bianca10naftanaila/Earthquake-detector/Project-pdf.pdf

UNIVERSITATEA POLITEHNICA BUCUREȘTI Facultatea de Electronică, Telecomunicații și Tehnologia Informației

Centrul de Electronică Tehnologică și Tehnici de Interconectare

## PROIECT TEHNOLOGII DE INTERCONECTARE ÎN ELECTRONICĂ

2022-2023

## „DETECTOR DE CUTREMUR”

STUDENȚI : | DATA DE PREDARE :
- Năftănăilă Bianca-Elena-422C | Iunie 2023
- Năftănăilă Luiza-Georgiana-422C
- Stroe Florin-Daniel-423D

COORDONATOR : Prof. Dr. Ing. Norocel-Dragoș Codreanu

## Cuprins

19. ANEXE

## Date inițiale de proiectare

Scopul acestui proiect este de a realiza design-ul PCB al unui detector de cutremur, conform unei scheme electrice și a unor parametrii dați. Detectorul de cutremur este realizat dintr-un piezoelement, care prin intermediul cristalelor de zirconat de plumb prezente în strucura sa, poate stoca cu ușurință curentul și îl poate elibera atunci când orientările cristalelor sunt perturbate prin vibrații mecanice, dintr-un amplificator operațional ce amplifică semnalele de la elementul piezoelectric și dintr-un dispozitiv stabil (timer) care generează întârzieri precise sau oscilații. Schema electrică a circuitului este reprezentată în figura Fig.1, iar detaliile despre aceasta se regăsesc în ANEXA 1.

Proiectul PCB va fi realizat utilizând două straturi electrice, TOP și BOTTOM. Componentele vor fi plasate pe stratul TOP, traseele de semnal vor avea lățimea de 0,4mm, traseele de alimentare vor avea lățimea de 1,0mm, conexiunea cu masa va fi realizată printr-un plan de masă pe stratul BOTTOM, iar spațierea în toate cazurile va fi de 0,4mm. Placa va fi dreptunghiulară, cu dimensiunea lungimii de 65mm și a lățimii de 55mm. Se vor plasa patru găuri nemetalizate de prindere în toate cele patru colțuri ale plăcii cu diametrul de 3,2mm. Fiecare gaură se va afla la 1,5 M (3,81mm) față de colțul în dreptul căruia a fost plasată. Aceste constrângeri de proiectare sunt specificate in ANEXA 2, linia 7.

Mai departe vor fi puse în evidență schema electrică a circuitului în programul „OrCAD Capture CIS”, o descriere a circuitului, cât și layer-ele proiectului PCB. Foile de catalog pentru componentele utilizate și link-urile propuse pentru achiziționarea acestora se găsesc în directorul „Foi de catalog”, fișierele pentru realizarea proiectului PCB se află în directorul „Fișiere pentru fabricație”, iar proiectul realizat în programul OrCAD se regăsește în directorul „Proiect PCB”. Toate aceste directoare se găsesc pe discul anexat. De asemenea, o propunere de proiectare mecanică a proiectului se află în ANEXA 5.

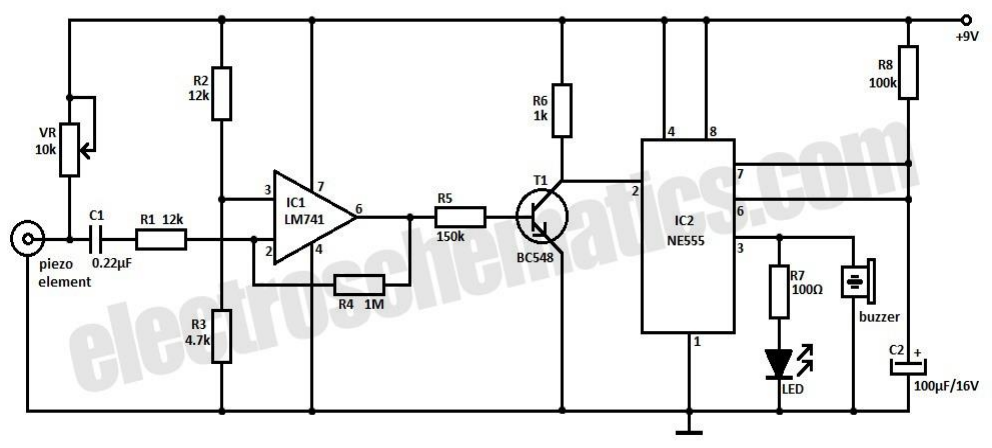
[picture p1: figure]

## Descriere a funcționării schemei proiectate

Componentele necesare schemei electrice sunt: circuit integrat NE555, buzzer, amplificator operațional LM741, potențiometru, piezoelement, condensator, rezistor, LED, tranzistor NPN.

Una dintre componentele principale ale schemei electrice este circuitul integrat NE555, un dispozitiv extrem de stabil pentru generarea unor întârzieri de timp precise sau oscilații. Acesta este alcătuit din 8 pini. Pinul 3 este conectat cu buzzer-ul și cu LED-ul pentru a sesiza vibrația. Terminalele suplimentare asigură declanșarea sau resetarea, dacă se dorește. În modul de funcționare a întârzierii, timpul este controlat cu precizie de un rezistor și de un condensator extern. Pentru o funcționare stabilă ca oscilator, frecvența de funcționare liberă și ciclul de funcționare sunt controlate cu precizie prin doi rezistori externi și un condensator.

Dispozitivul LM741 este un amplificator operațional ce prezintă performanțe îmbunătățite, destinat unei game largi de aplicații analogice. Câștigul mare și gama largă de tensiuni de operare oferă performanțe superioare în integrator. Așadar, IC1 LM741 este conectat în circuit ca un amplificator diferențial ale cărui intrări, atât cea inversoare, cât și cea neinversoare , sunt legate de borna negativă printr-o rețea rezistivă care cuprinde R1 și R4. În condiții de inactivitate (ajustată de VR1), ambele intrări primesc tensiuni aproape egale.

De asemenea, este utilizat un senzor piezo standard ce detectează vibrațiile/sunetele cauzate de schimbările de presiune. Prin intermediul cristalelor de zirconat de plumb prezente în strucura sa, poate stoca cu ușurință curentul și îl poate elibera atunci când orientările cristalelor sunt perturbate de vibrațiile mecanice Astfel, elementul piezo acționează ca un mic condensator ce are o capacitate de câțiva nanofarazi. De aceea, la fel ca un condensator, acesta stochează sarcina atunci când un potențial este aplicat la bornele sale.

Când elementul piezo este perturbat (chiar și de o mișcare ușoară), acesta descarcă încărcătura stocată. Acest lucru modifică nivelul de tensiune la intrările lui IC1 și ieșirea oscilează momentan în sus. Această ieșire ridicată este utilizată pentru a declanșa tranzistorul de comutare T1, care la rândul său declanșează monostabilul IC2. Ieșirea ridicată a acestuia activează soneria buzzer-ului și determină aprinderea LED-ului.

## Schema electrică

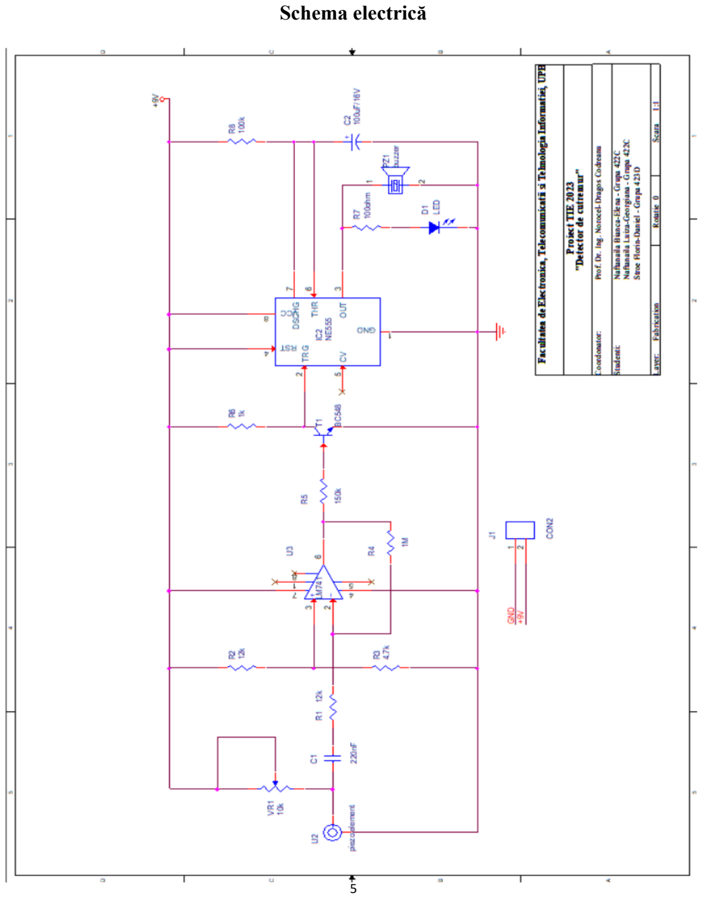
[picture p2: page 5]

## Raport de postprocesare „Design Rules Check”(DRC)

Design Rules Check

Checking Schematic: SCHEMATIC1

Checking Electrical Rules

Checking For Single Node Nets

Checking For Unconnected Bus Nets

## Raport de postprocesare „Cross Reference”(CR)

Cross Reference | Page1
Item | Part | Reference | SchematicName | Sheet | Library

____________________________________________________________________________

1 | 1M | R4 | SCHEMATIC1/PAGE1 | 1
C:\CADENCE\SPB_17.2\TOOLS\CAPTURE\LIBRARY\DISCRETE.OLB
2 | 1k | R6 | SCHEMATIC1/PAGE1 | 1
C:\CADENCE\SPB_17.2\TOOLS\CAPTURE\LIBRARY\DISCRETE.OLB
3 | 4.7k | R3 | SCHEMATIC1/PAGE1 | 1
C:\CADENCE\SPB_17.2\TOOLS\CAPTURE\LIBRARY\DISCRETE.OLB
4 | 10k | VR1 | SCHEMATIC1/PAGE1 | 1
C:\CADENCE\SPB_17.2\TOOLS\CAPTURE\LIBRARY\DISCRETE.OLB
5 | 12K | R1 | SCHEMATIC1/PAGE1 | 1
C:\CADENCE\SPB_17.2\TOOLS\CAPTURE\LIBRARY\DISCRETE.OLB
6 | 12K | R2 | SCHEMATIC1/PAGE1 | 1
C:\CADENCE\SPB_17.2\TOOLS\CAPTURE\LIBRARY\DISCRETE.OLB
7 | 100k | R8 | SCHEMATIC1/PAGE1 | 1
C:\CADENCE\SPB_17.2\TOOLS\CAPTURE\LIBRARY\DISCRETE.OLB
8 | 100ohm | R7 | SCHEMATIC1/PAGE1 | 1
C:\CADENCE\SPB_17.2\TOOLS\CAPTURE\LIBRARY\DISCRETE.OLB
9 | 100uF/16V C2 | SCHEMATIC1/PAGE1 | 1
C:\CADENCE\SPB_17.2\TOOLS\CAPTURE\LIBRARY\DISCRETE.OLB
10 | 150k | R5 | SCHEMATIC1/PAGE1 | 1
C:\CADENCE\SPB_17.2\TOOLS\CAPTURE\LIBRARY\DISCRETE.OLB
11 | 220nF | C1 | SCHEMATIC1/PAGE1 | 1
C:\CADENCE\SPB_17.2\TOOLS\CAPTURE\LIBRARY\DISCRETE.OLB
12 | BC548 | T1 | SCHEMATIC1/PAGE1 | 1
C:\CADENCE\SPB_17.2\TOOLS\CAPTURE\LIBRARY\TRANSISTOR.OLB
13 | CON2 | J1 | SCHEMATIC1/PAGE1 | 1
C:\CADENCE\SPB_17.2\TOOLS\CAPTURE\LIBRARY\CONNECTOR.OLB
14 | LED | D1 | SCHEMATIC1/PAGE1 | 1
C:\CADENCE\SPB_17.2\TOOLS\CAPTURE\LIBRARY\DISCRETE.OLB
15 | LM741 | IC1 | SCHEMATIC1/PAGE1 | 1
C:\CADENCE\SPB_17.2\TOOLS\CAPTURE\LIBRARY\OPAMP.OLB
16 | NE555 | IC2 | SCHEMATIC1/PAGE1 | 1 | C:\USERS\USER\DESKTOP\TIE
LABORATOR\PROIECT_TIE_DETECTOR_DE_CUTREMUR.DSN
17 | buzzer | PZ1 | SCHEMATIC1/PAGE1 | 1
C:\CADENCE\SPB_17.2\TOOLS\CAPTURE\LIBRARY\DISCRETE.OLB
18 | piezo element U2 | SCHEMATIC1/PAGE1 | 1
C:\CADENCE\SPB_17.2\TOOLS\CAPTURE\LIBRARY\PIEZOELEMENT.OLB

## Raport de postprocesare „Bill of Materials”(BOM)

Bill Of Materials | Page1
Item | Quantity | Reference | Part

______________________________________________

1 | 1 | C1 | 220nF
2 | 1 | C2 | 100uF/16V
3 | 1 | D1 | LED
4 | 1 | IC1 | LM741
5 | 1 | IC2 | NE555
6 | 1 | J1 | CON2
7 | 1 | PZ1 | buzzer
8 | 2 | R1,R2 | 12k
9 | 1 | R3 | 4.7k
10 | 1 | R4 | 1M
11 | 1 | R5 | 150k
12 | 1 | R6 | 1k
13 | 1 | R7 | 100ohm
14 | 1 | R8 | 100k
15 | 1 | T1 | BC548
16 | 1 | U2 | piezo element
17 | 1 | VR1 | 10k

Nr. Curent | Cantitate | Referință | Componentă | Descrierere | Montare | Capsulă | Producător | Distribuitor | Cod Produs | Preț / buc. (RON) | Cantitate minimă | Preț total
1 | 1 | U2 | piezo element | Piezo Element, Sounder, 9.5 kHz, 8000 pF, 12 mm, 0.22 mm | THT | JUMPER2 | MULTICOMP PRO | ro.farnell.com | MCABT-456-RC | 2,07 | 1 | 2,07
2 | 1 | VR1 | 10k | Trimpot, Single Turn, Cermet, Top Adjust, 10 kohm, Surface Mount, 1 Turns | SMD | POT | BOURNS | ro.farnell.com | TC33X-2-103E | 1,18 | 5 | 5,9
3 | 1 | C1 | 220 nF | SMD Multilayer Ceramic Capacitor, 0.22 µF, 50 V, 1206 [3216 Metric], ± 10%, X7R, CC Series | SMD | CAPCK06 | YAGEO | ro.farnell.com | CC1206KKX7R9BB224 | 0,5831 | 5 | 2,9
4 | 2 | R1, R2 | 12k | METAL FILM RESISTOR, 12KOHM, 125mW, 1% | THT | RES400 | MULTICOMP PRO | ro.farnell.com | MCMF0W8FF1202A20 | 0,357 | 1 | 0,357
5 | 1 | R3 | 4,7k | CARBON FILM RESISTOR, 4.7KOHM, 500mW 5% | THT | RES400 | MULTICOMP PRO | ro.farnell.com | MCCFR0S2J0472A20 | 0,42 | 1 | 0,42
6 | 1 | R4 | 1M | SMD Chip Resistor, Ceramic, 1 Mohm, ± 1%, 62.5 mW, 0402 [1005 Metric], Thick Film, Sulfur Resistant | SMD | SMR1206 | MULTICOMP PRO | ro.farnell.com | MCMR04X1004FTL | 0,0476 | 10 | 0,476
7 | 1 | R5 | 150k | SMD Chip Resistor, 150 kohm, ± 1%, 62.5 mW, 0402 [1005 Metric], Thick Film, General Purpose | SMD | SMR1206 | TE CONNECTIVITY | ro.farnell.com | CRG0402F150K | 0,0238 | 10 | 0,238
8 | 1 | R6 | 1k | METAL FILM RESISTOR, 1KOHM, 250mW, 1% | THT | RES400 | MULTICOMP PRO | ro.farnell.com | MCMF0W4FF1001A50 | 0,4522 | 1 | 0,4522
9 | 1 | R7 | 100ohm | SMD Chip Resistor, Ceramic, 100 ohm, ± 1%, 100 mW, 0603 [1608 Metric], Thick Film, Sulfur Resistant | SMD | 0603 (1608 Metric) | MULTICOMP PRO | ro.farnell.com | MCMR06X1000FTL | 0,0595 | 10 | 0,595
10 | 1 | R8 | 100k | SMD Chip Resistor, 100 kohm, ± 1%, 100 mW, 0603 [1608 Metric], Thick Film, General Purpose | SMD | 0603 (1608 Metric) | YAGEO | ro.farnell.com | RC0603FR-13100KL | 0,0476 | 10 | 0,476
11 | 1 | J1 | CON2 | Standard Terminal Block, CTB, 2 Contacts, 5 mm, Terminal Block, PCB Mount, 12 AWG | THT | JUMPER2 | CAMDENBOSS | ro.farnell.com | CTB55VG/2 | 2,2 | 1 | 2,2
12 | 1 | T1 | BC548 | Bipolar (BJT) Single Transistor, NPN, 65 V, 100 mA, 250 mW, SOT-23, Surface Mount | SMD | SOT-23 | MULTICOMP PRO | ro.farnell.com | BC846B | 0,6307 | 5 | 3,1535
13 | 1 | C2 | 100 uF/16V | Electrolytic Capacitor, 100 µF, 25 V, ± 20%, Radial Leaded, 2000 hours @ 85°C, Polar | THT | CAP196 | MULTICOMP PRO | ro.farnell.com | MCGPR25V107M6.3X11 | 0,7735 | 1 | 0,7735
14 | 1 | PZ1 | buzzer | Buzzer, Continuous, PS Series, 3V, 4 kHz, 75dBA, Through Hole | THT | JUMPER2 | TDK | ro.farnell.com | PS1440P02BT | 3,8437 | 1 | 3,8437
15 | 1 | D1 | LED | LED, Cool White, Through Hole, T-1 3/4 (5mm), 20 mA, 3.2 V, 4.18 cd | THT | CAP196 | CREE LED | ro.farnell.com | C535A-WJN-CU0W0231 | 1,2376 | 1 | 1,2376
16 | 1 | IC1 | LM741 | Operational Amplifier, 1 Amplifier, 1 MHz, 0.5 V/µs, 10V to 36V, DIP, 8 Pins | SMD | DIP8_3 | TEXAS INSTRUMENTS | ro.farnell.com | LM741CN/NOPB | 5,0337 | 1 | 5,0337
17 | 1 | IC2 | NE555 | Precision Timer IC, Timing Microseconds to Hours, TTL, Astable, Monostable, 4.5 V to 16 V, SOIC-8 | SMD | SOIC-8 | TEXAS INSTRUMENTS | ro.farnell.com | NE555D | 2,8917 | 1 | 2,8917

## Raport de postprocesare „Bill of Materials”(BOM-Avansat)

Preț total: 33,0179 lei

## Raport de postprocesare „Wirelist”(WR)

Wire List

<<< Component List >>>

220nF | C1 | CAPCK06
100uF/16V | C2 | CAP196
LED | D1 | CAP196
LM741 | IC1 | DIP8_3
NE555 | IC2 | SOIC8
CON2 | J1 | JUMPER2
buzzer | PZ1 | JUMPER2
12k | R1 | RES400
12k | R2 | RES400
4.7k | R3 | RES400
1M | R4 | SMR1206
150k | R5 | SMR1206
1k | R6 | RES400
100ohm | R7 | RES1608X50N_0603
100k | R8 | RES1608X50N_0603
BC548 | T1 | SOT23_3
piezo element | U2 | JUMPER2
10k | VR1 | POT

<<< Wire List >>>

NODE REFERENCE PIN # PIN NAME | PIN TYPE | PART VALUE
[00001] +9V
IC1 | 7 | V+ | Power | LM741
IC2 | 4 | RST | Input | NE555
IC2 | 8 | VCC | Power | NE555
R2 | 1 | 1 | Passive | 12k

R6 | 1 | 1 | Passive | 1k
R8 | 1 | 1 | Passive | 100k
J1 | 2 | 2 | Passive | CON2
VR1 | 1 | A | Passive | 10k
VR1 | 2 | WIPER | Passive | 10k
[00002] GND
IC1 | 4 | V- | Power | LM741
IC2 | 1 | GND | Power | NE555
T1 | 1 | EMITTER | Passive | BC548
R3 | 2 | 2 | Passive | 4.7k
C2 | 2 | 2 | Passive | 100uF/16V
J1 | 1 | 1 | Passive | CON2
PZ1 | 2 | - | Passive | buzzer
D1 | 2 | CATHODE | Passive | LED
U2 | 2 | pin2 | Passive | piezo element
[00003] N00855
R2 | 2 | 2 | Passive | 12k
R3 | 1 | 1 | Passive | 4.7k
[00004] N00880
C1 | 2 | 2 | Passive | 220nF
VR1 | 3 | B | Passive | 10k
U2 | 1 | pin1 | Passive | piezo element
[00005] N00920
IC2 | 6 | THR | Input | NE555
IC2 | 7 | DSCHG | Passive | NE555
R8 | 2 | 2 | Passive | 100k
C2 | 1 | 1 | Passive | 100uF/16V

[00006] N00981
IC2 | 2 | TRG | Input | NE555
T1 | 3 | COLLECTOR | Passive | BC548
R6 | 2 | 2 | Passive | 1k
[00007] N01004
T1 | 2 | BASE | Input | BC548
R5 | 2 | 2 | Passive | 150k
[00008] N01012
R4 | 2 | 2 | Passive | 1M
R5 | 1 | 1 | Passive | 150k
[00009] N01016
R1 | 2 | 2 | Passive | 12k
R4 | 1 | 1 | Passive | 1M
[00010] N01043
C1 | 1 | 1 | Passive | 220nF
R1 | 1 | 1 | Passive | 12k
[00011] N01268
IC2 | 3 | OUT | Output | NE555
R7 | 1 | 1 | Passive | 100ohm
PZ1 | 1 | + | Passive | buzzer
[00012] N01306
R7 | 2 | 2 | Passive | 100ohm
D1 | 1 | ANODE | Passive | LED

## Verificarea net-urilor

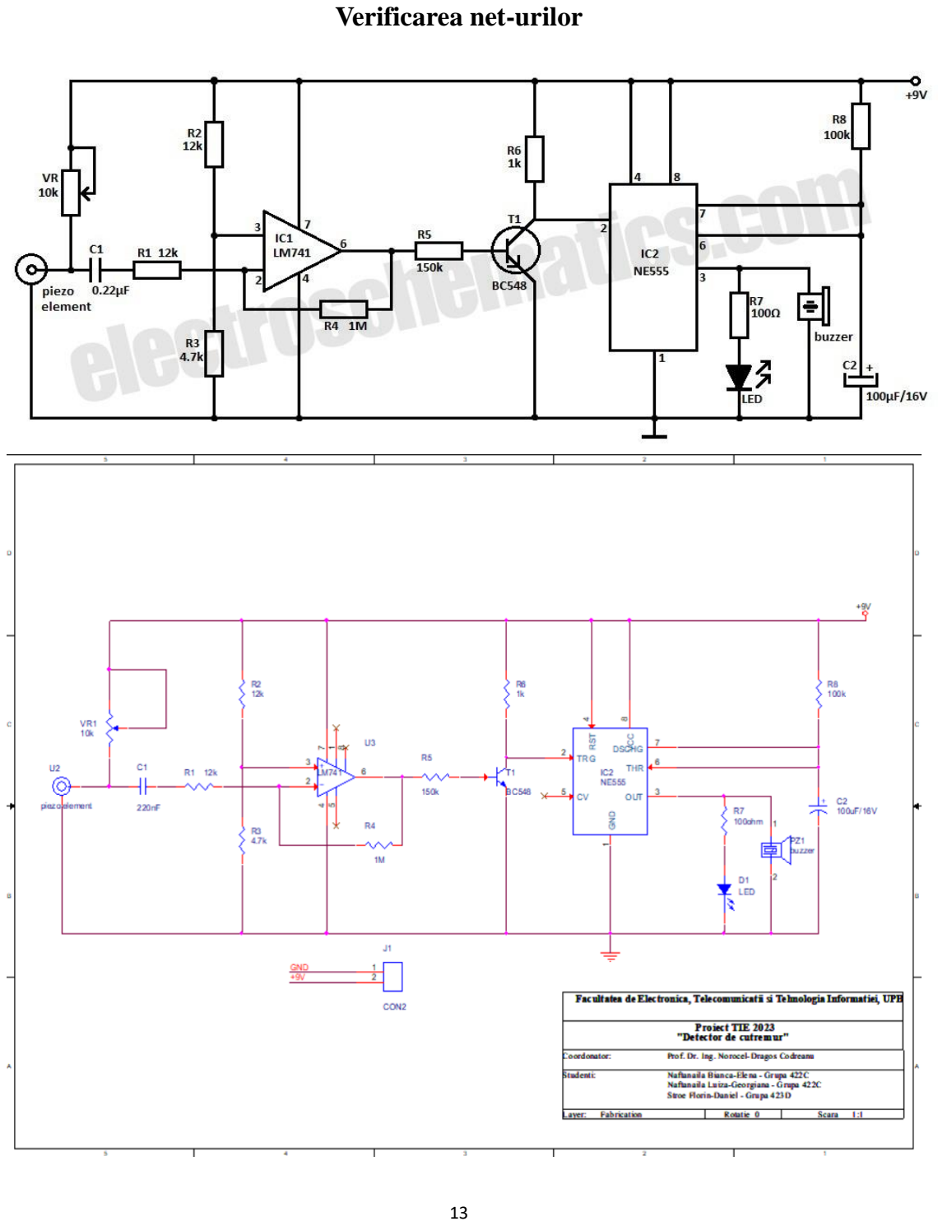
[picture p3: page 13]

## Layout-ul generat de straturile electrice „TOP” și „BOTTOM”

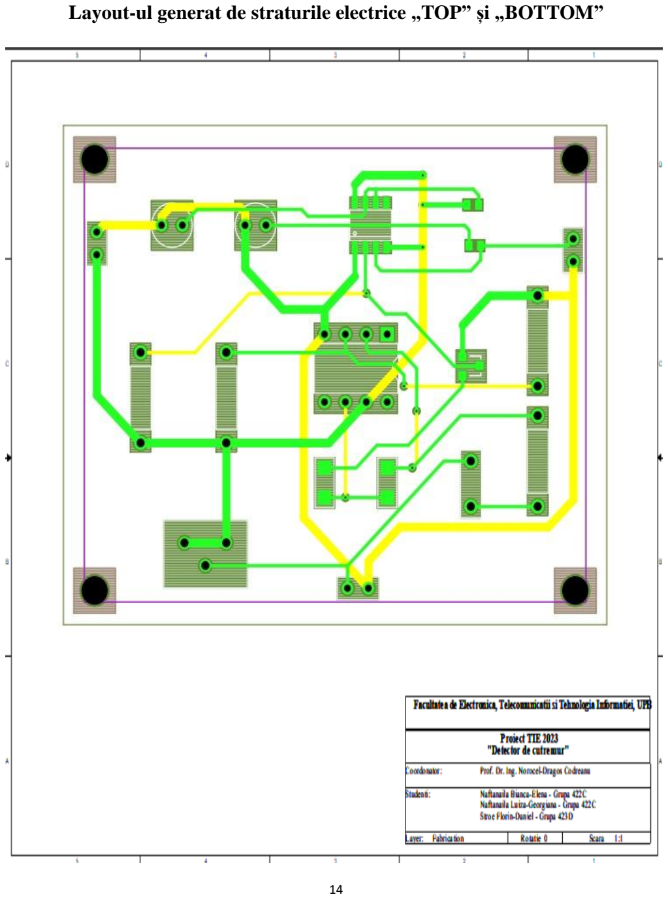
[picture p4: page 14]

## Layer Copper TOP

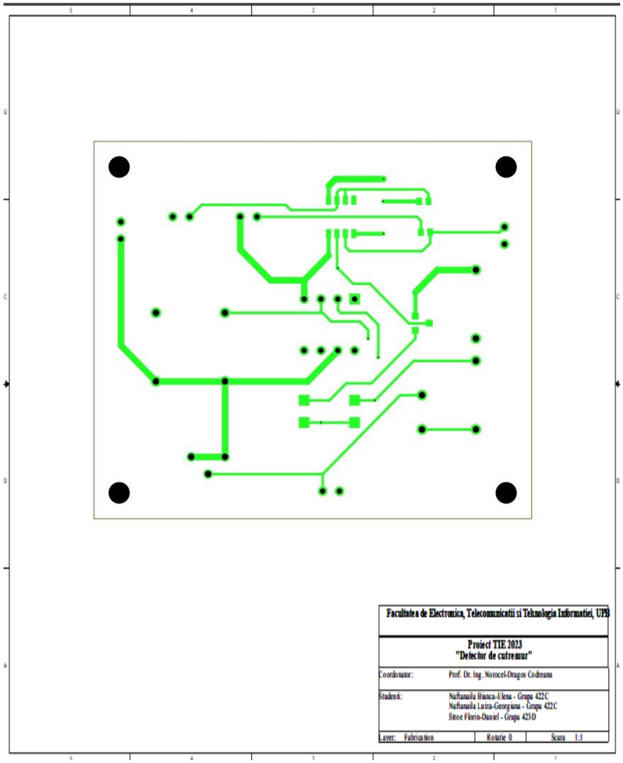
[picture p5: figure]

*Conturul plăcii nu face parte din layer. A fost adăugat și layer-ul OUTLINE ca referință de poziție

## Layer Copper BOTTOM

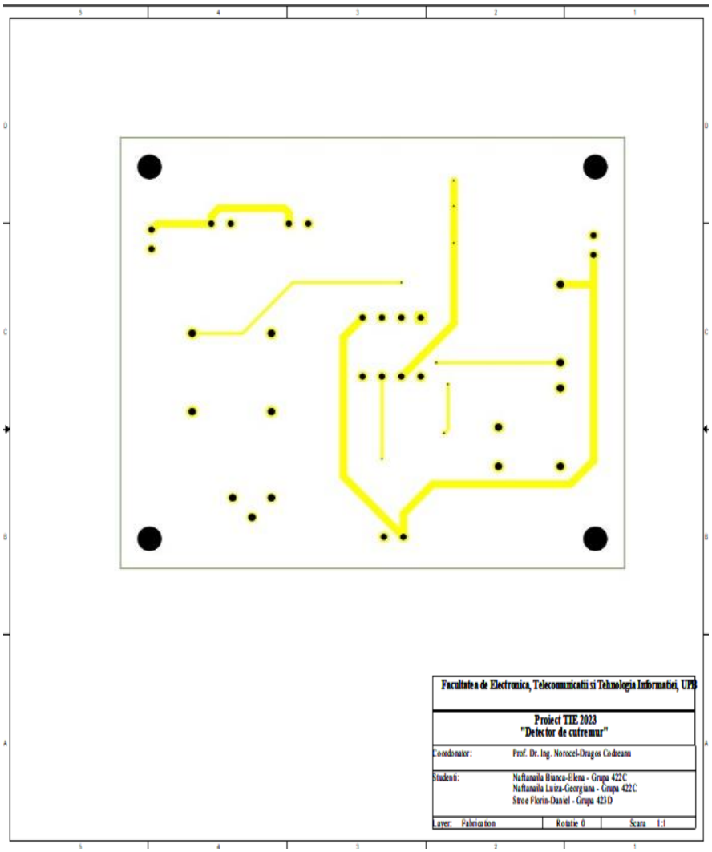
[picture p6: figure]

*Conturul plăcii nu face parte din layer. A fost adăugat și layer-ul OUTLINE ca referință de poziție.

## Layer Solder Mask TOP

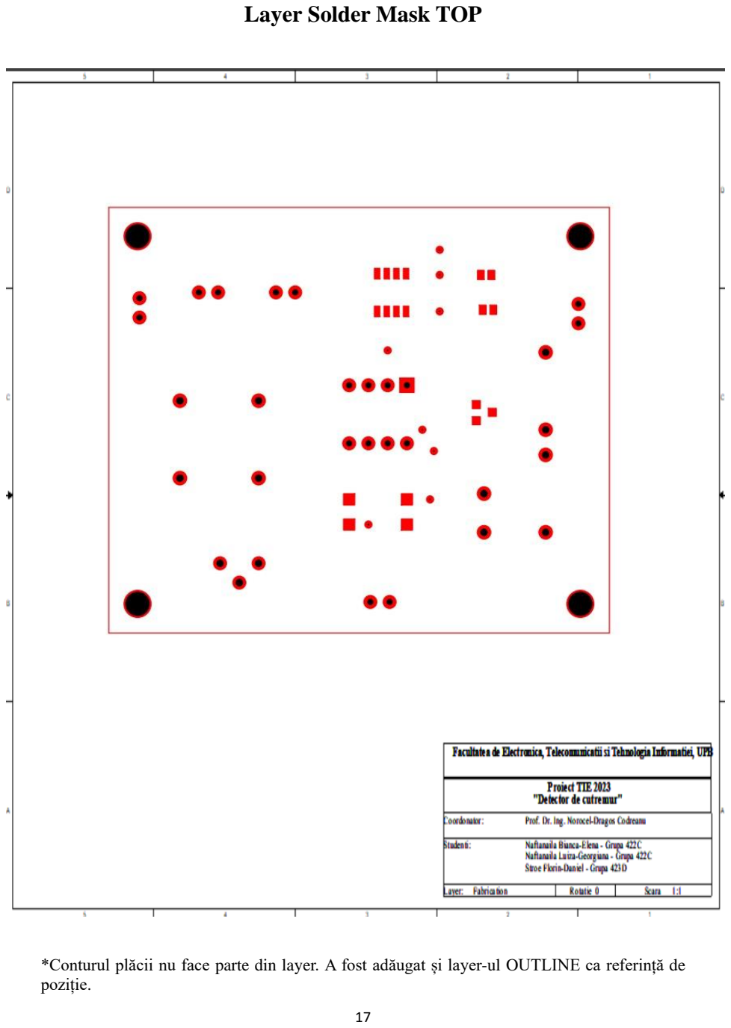
[picture p7: page 17]

*Conturul plăcii nu face parte din layer. A fost adăugat și layer-ul OUTLINE ca referință de poziție.

## Layer Solder Mask BOTTOM

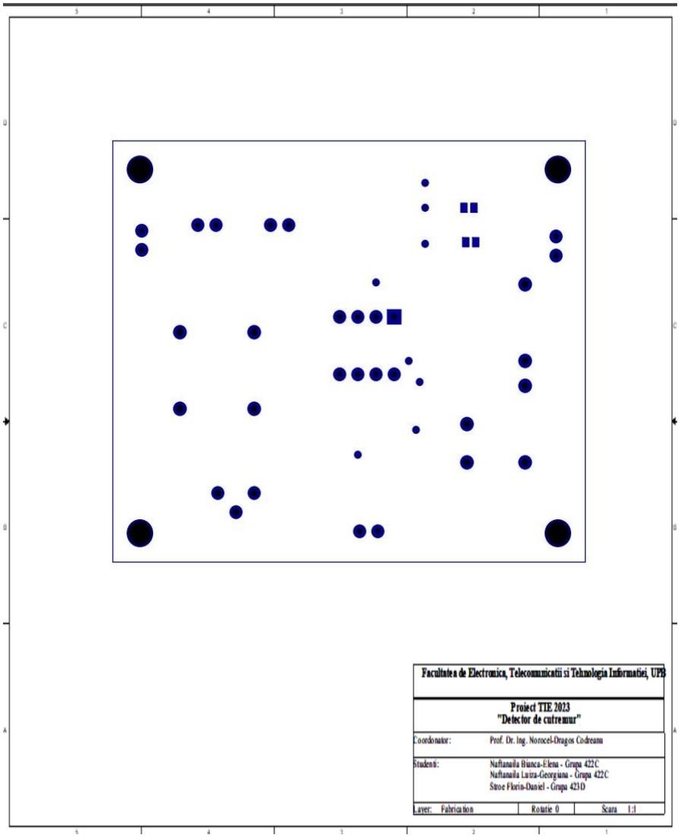
[picture p8: figure]
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

## Layer Silk Screen TOP

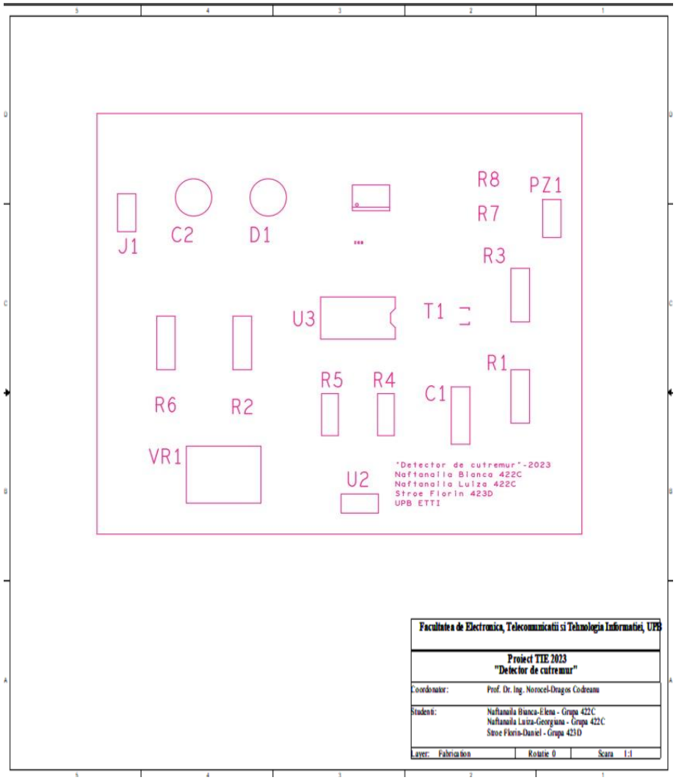
[picture p9: figure]
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

## Layer Assembly Drawing TOP

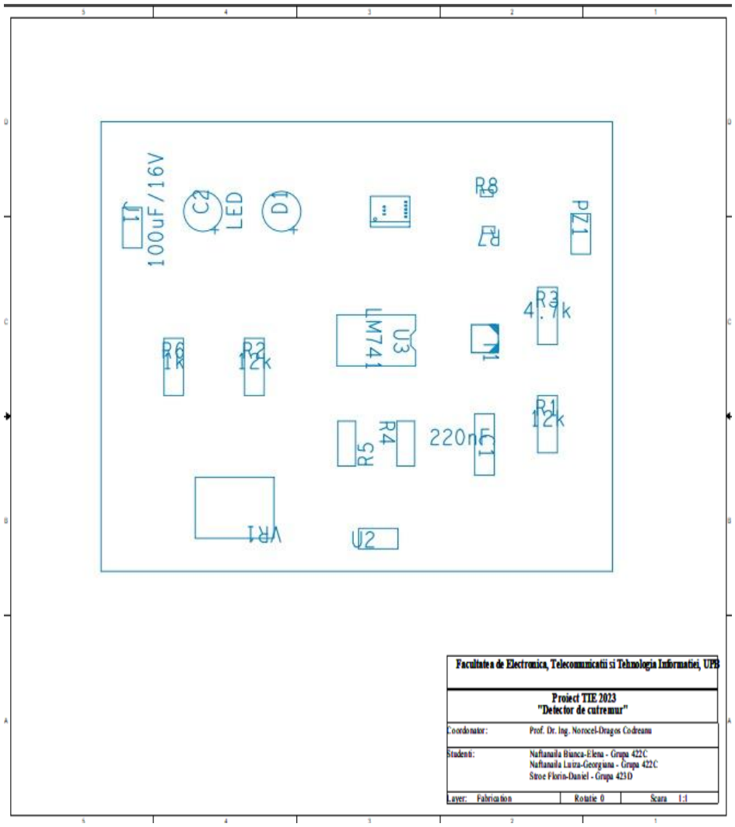
[picture p10: figure]
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

## Layer Fabrication

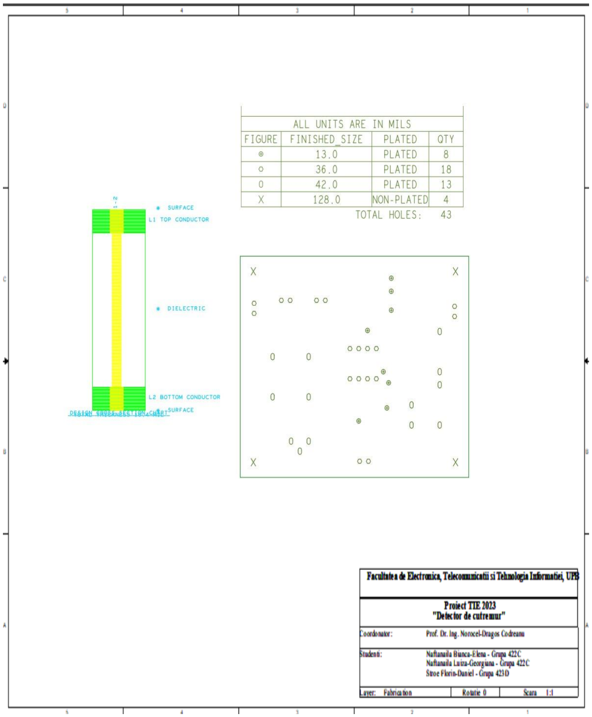
[picture p11: figure]

## Concluzii

În cadrul acestui proiect s-a studiat și realizat design-ul PCB al unui circuit detector de cutremur prin înțelegerea eficacității fiecărei componente și a funcționalității întregului circuit.

Proiectarea schemei electrice s-a realizat în programul „OrCAD Capture CIS”, versiunea 17.2 – 2020 Lite. Schema este reprezentată pe o singură pagină ce conține 18 componente: rezistori, condensatoare, LED, tranzistor, potențiometru, conector, piezo element, buzzer, circuit integrat NE555 și amplificator LM741. Part-ul creat este piezo elementul . Piezo elementul este un senzor ce detectează vibrațiile sau sunetele cauzate de schimbările de presiune, având 2 pini de tip „input”, iar circuitul integrat NE555 este un dispozitiv stabil ce generează întârzieri de timp precise sau oscilații, având în alcătuirea lui 8 pini, 4 de tip „input”, unul de tip „passive”, 2 de tip „power” și unul de tip „output”.

Proiectarea structurii de interconectare PCB a modulului electronic, mai exact proiectarea circuitului imprimat, s-a realizat în programul „OrCAD PCB Editor Lite”. În cadrul proiectării s-a ținut cont de următoarele constrângeri de proiectare: lățimea traseelor de semnal de 0,4 mm (16 mili), lățimea traseelor de masă/alimentare de 1 mm (40 mili) și spațierea în toate cazurile de 0,4 mm (16 mili). Componentele au fost plasate astfel încât să se respecte schema electrică dată și să existe posibilitatea rutării traseelor atât pe layer-ul TOP cât și pe layer-ul BOTTOM.

Proiectarea mecanică a modulului a fost efectuată în programul „OrCAD PCB Editor Lite” versiunea 17.2. Conturul plăcii are dimensiunea de 65mm x 55mm (2600mili x 2200mili), board edge clearance fiind setat la 100 mili. Pe placă au fost plasate în cele 4 colțuri ale boardului găuri de prindere la distanță de 1,5 M (150 mili) și cu diametru de 128 mili. Circuitele integrate au fost plasate în centrul plăcii pentru a fi protejate, iar conectorii au fost poziționați pe marginea plăcii.

## Bibliografie/ Webografie

- https://www.cetti.ro/v2/
- https://ro.farnell.com/
- https://www.youtube.com/watch?v=A8tzRujELIY&ab_channel=Pass ars (https://www.youtube.com/watch?v=A8tzRujELIY&ab_channel=Passars)
- https://projectiot123.com/
- https://www.electroschematics.com/seismic-sensor/

## ANEXA 1

Circuitul detector de cutremur

Circuitul din Figura 1 este un circuit detector de cutremur foarte sensibil, care poate detecta vibrațiile seismice.

Poate fi utilizat pentru a detecta vibrațiile din pământ. Prin urmare, este un dispozitiv ideal pentru monitorizarea intrărilor. Circuitul exploatează proprietatea piezoelectrică directă a elementului piezoelectric folosit în buzzere.

Cristalele de zirconat de plumb prezente în elementul piezoelectric pot stoca ușor sarcina electrică și o pot elibera atunci când orientarea cristalelor este perturbată prin vibrații mecanice. Circuitul integrat IC1 amplifică semnalele de la elementul piezoelectric și ieșirea mare de la IC1 activează tranzistorul T1.

Când tranzistorul T1 conduce, pinul de declanșare 2 al monostabilului (IC2) va fi conectat la masă pentru a oferi o ieșire mare.

Această ieșire mare este folosită pentru a declanșa alarma și pentru a aprinde LED-ul. Potențiometrul VR ajustează sensibilitatea elementului piezoelectric. Se lipește partea fină a elementului piezoelectric pe podea (dacă este folosit ca alarmă de intrare) sau într-o cutie metalică (dacă este utilizat pentru a fi îngropat pentru a detecta vibrațiile din pământ).

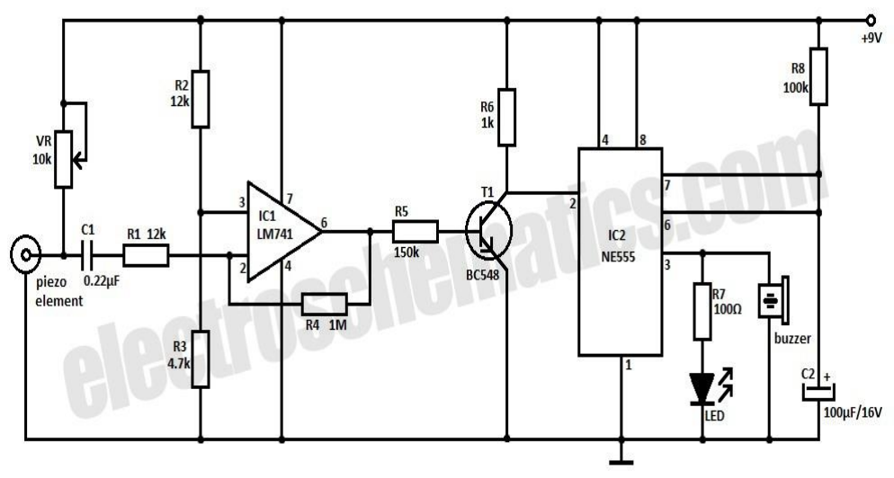
[picture p12: figure]

## ANEXA 2

## Specificaţii şi valori pentru proiect

Echipa (“Team”) | 2.3 [mm] | 2.4 [mm] | 2.5 [mm] | 3.1, 3.2: forma şi dimensiunile plăcii [mm] & info cu privire la găurile de prindere (g.p.)
1 | 0,2 | 1,2 | 0,4 | Dreptunghi, 70x50, cu 3 g.p. în 3 colţuri, plasate la 2 M distanţă de colţuri
2 | 0,3 | 1,1 | 0,35 | Dreptunghi, 70x55, cu 4 g.p. în cele 4 colţuri, plasate la 1,5 M distanţă de colţuri
3 | 0,4 | 1 | 0,25 | Dreptunghi, 70x60, cu 2 g.p. în 2 colţuri pe diagonală, plasate la 1,5 M distanţă de colţuri
4 | 0,5 | 0,9 | 0,4 | Pătrat, 65x65, cu 4 g.p. în cele 4 colţuri, plasate la 2 M distanţă de colţuri
5 | 0,2 | 1,2 | 0,35 | Pătrat, 50x50, cu 2 g.p. în 2 colţuri pe diagonală, plasate la 2 M distanţă de colţuri
6 | 0,3 | 1,1 | 0,25 | Pătrat, 60x60, cu 3 g.p. în 3 colţuri, plasate la 1,5 M distanţă de colţuri
7 | 0,4 | 1 | 0,4 | Dreptunghi, 65x55, cu 4 g.p. în cele 4 colţuri, plasate la 1,5 M distanţă de colţuri
8 | 0,5 | 0,9 | 0,35 | Dreptunghi, 75x45, cu 3 g.p. în 3 colţuri, plasate la 2 M distanţă de colţuri
9 | 0,2 | 1,2 | 0,25 | Dreptunghi, 70x55, cu 2 g.p. în 2 colţuri pe diagonală, plasate la 2 M distanţă de colţuri
10 | 0,3 | 1,1 | 0,4 | Pătrat, 70x70, cu 3 g.p. în 3 colţuri, plasate la 2 M distanţă de colţuri
11 | 0,4 | 1 | 0,35 | Pătrat, 55x55, cu 4 g.p. în cele 4 colţuri, plasate la 1,5 M distanţă de colţuri
12 | 0,5 | 0,9 | 0,25 | Pătrat, 65x65, cu 2 g.p. în 2 colţuri pe diagonală, plasate la 1,5 M distanţă de colţuri
13 | 0,2 | 1,1 | 0,4 | Dreptunghi, 75x45, cu 2 g.p. în 2 colţuri pe diagonală, plasate la 2 M distanţă de colţuri
14 | 0,25 | 1,2 | 0,35 | Dreptunghi, 75x60, cu 4 g.p. în colţuri, plasate la 2 M distanţă de colţuri
15 | 0,35 | 1 | 0,3 | Pătrat, 75X75, cu 3 g.p. în 3 colţuri, plasate la 1,5 M distanţă de colţuri

## ANEXA 3

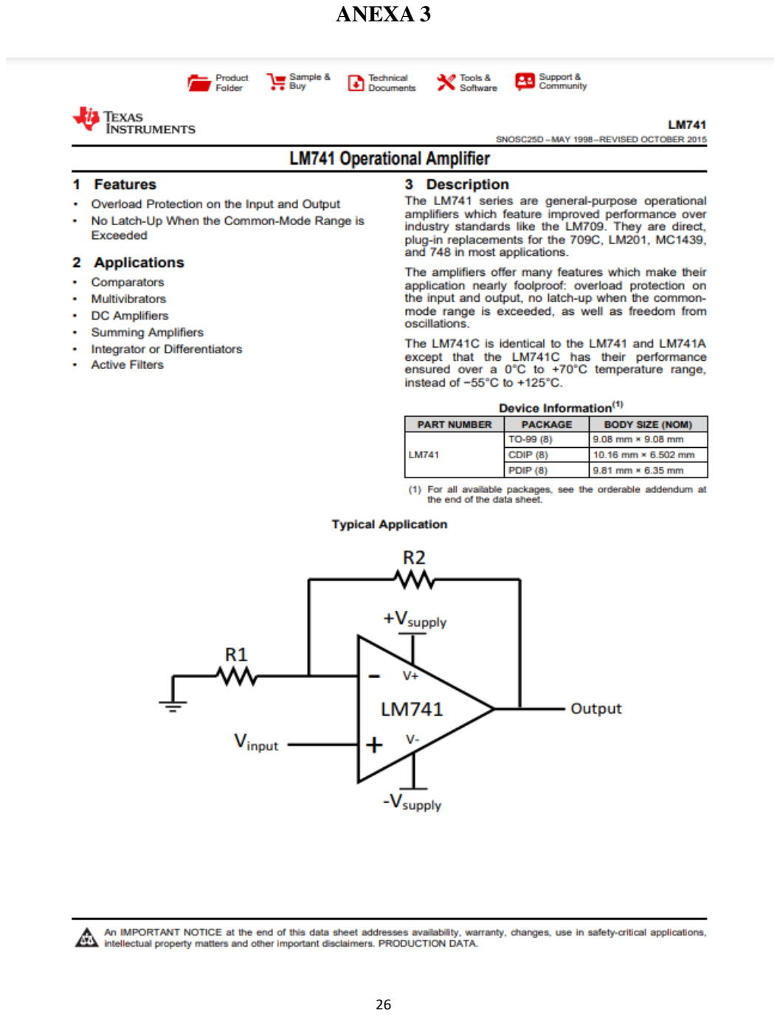
[picture p13: page 26]

## ANEXA 4

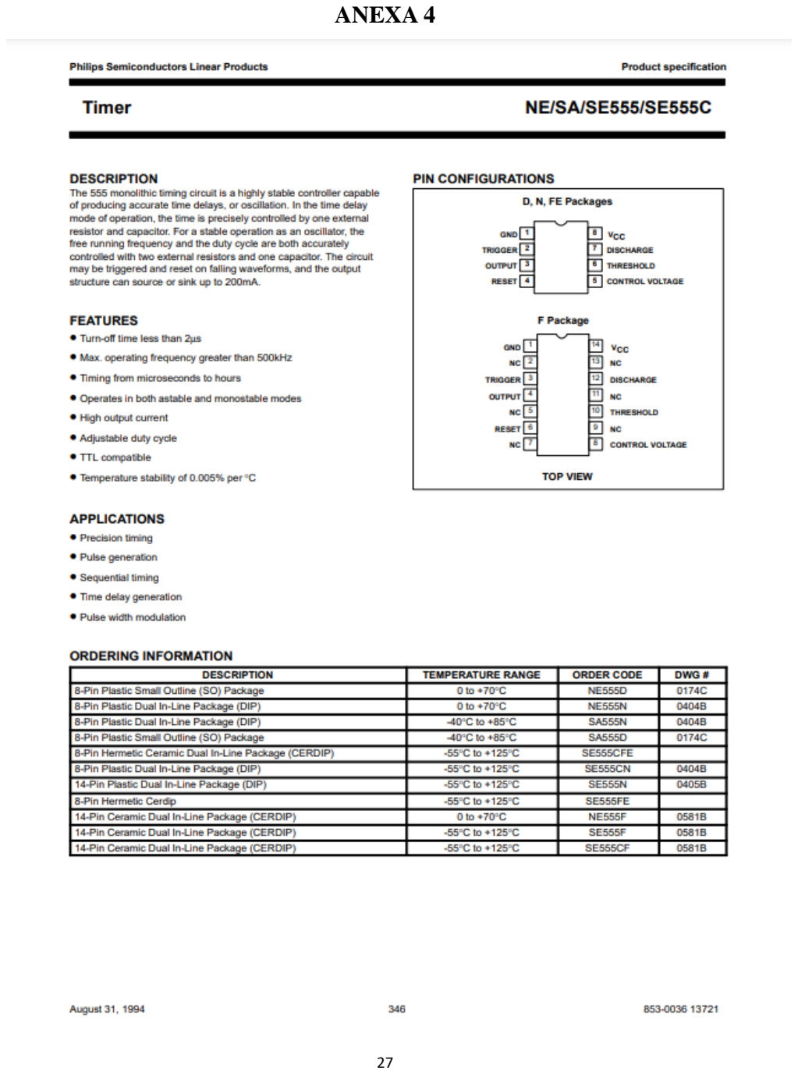
[picture p14: page 27]

## ANEXA 5

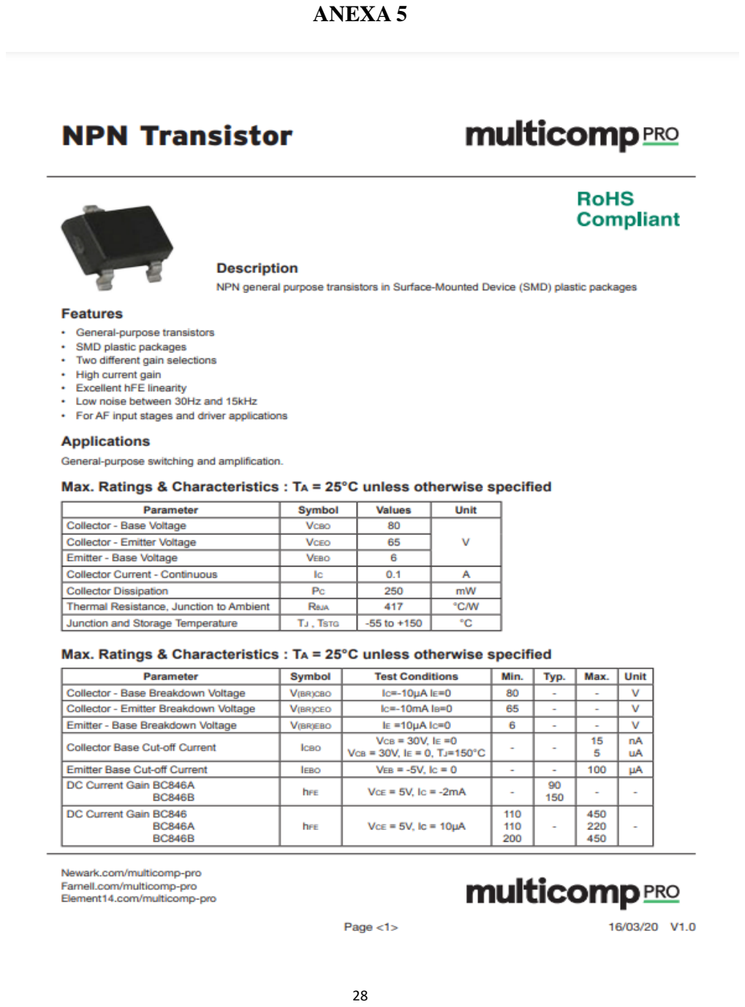
[picture p15: page 28]

## ANEXA 6

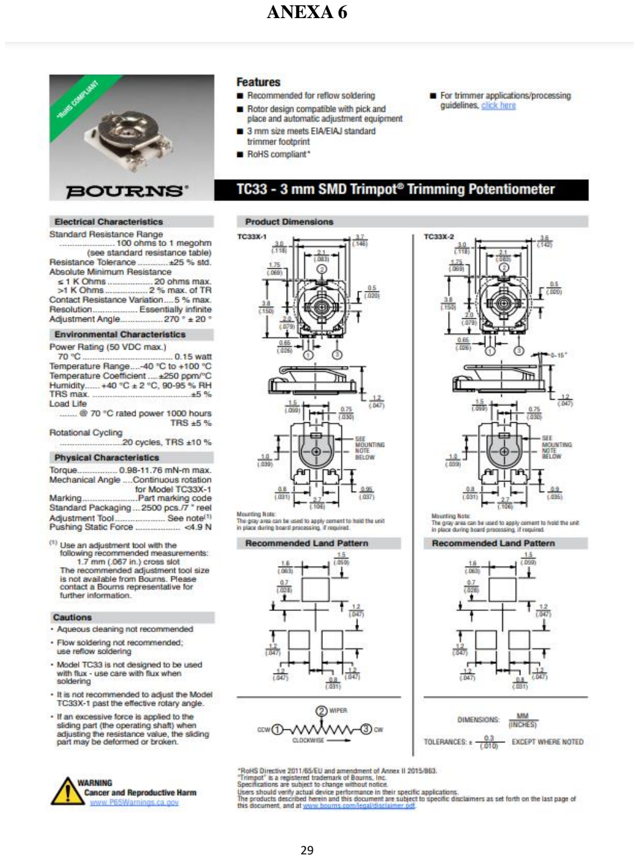
[picture p16: page 29]

## ANEXA 7

Nr.
Cure
nt

Link

1 | https://ro.farnell.com/multicomp/mcabt-456-rc/audio-element-piezo-9-5khz-12mm/dp/2433032?ost=mcabt-456-rc (https://ro.farnell.com/multicomp/mcabt-456-rc/audio-element-piezo-9-5khz-12mm/dp/2433032?ost=mcabt-456-rc)
2 https://ro.farnell.com/bourns/tc33x-2-103e/trimmer-10k-3mm/dp/1689863?st=tc33x-2- | 103e (https://ro.farnell.com/bourns/tc33x-2-103e/trimmer-10k-3mm/dp/1689863?st=tc33x-2-103e)
3 https://ro.farnell.com/avx/sr215c224kar/cap-0-22-f-50v-10- | x7r/dp/2332986?st=0,22%20uf (https://ro.farnell.com/avx/sr215c224kar/cap-0-22-f-50v-10-x7r/dp/2332986?st=0,22%20uf)
4 https://ro.farnell.com/multicomp-pro/mcmf0w8ff1202a20/metal-film-resistor-12kohm- | 125mw/dp/1127027?ost=mcmf0w8ff1202a20 (https://ro.farnell.com/multicomp-pro/mcmf0w8ff1202a20/metal-film-resistor-12kohm-125mw/dp/1127027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)
5 | https://ro.farnell.com/multicomp-pro/mccfr0s2j0472a20/carbon-film-resistor-4-7kohm-500mw/dp/1128722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 (https://ro.farnell.com/multicomp-pro/mccfr0s2j0472a20/carbon-film-resistor-4-7kohm-500mw/dp/1128722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)
6 https://ro.farnell.com/multicomp/mcmr04x1004ftl/res-1m-1-0-0625w-0402- | ceramic/dp/2072521 (https://ro.farnell.com/multicomp/mcmr04x1004ftl/res-1m-1-0-0625w-0402-ceramic/dp/2072521)
7 https://ro.farnell.com/te-connectivity/crg0402f150k/res-150k-1-0-063w-0402-thick- | film/dp/2331460 (https://ro.farnell.com/te-connectivity/crg0402f150k/res-150k-1-0-063w-0402-thick-film/dp/2331460)
8 https://ro.farnell.com/multicomp-pro/mcmf0w4ff1001a50/metal-film-resistor-1kohm- | 250mw/dp/1126919?st=resistor%201k (https://ro.farnell.com/multicomp-pro/mcmf0w4ff1001a50/metal-film-resistor-1kohm-250mw/dp/1126919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)
9 https://ro.farnell.com/multicomp/mcmr06x1000ftl/res-100r-1-0-1w-0603- | ceramic/dp/2073347 (https://ro.farnell.com/multicomp/mcmr06x1000ftl/res-100r-1-0-1w-0603-ceramic/dp/2073347)
10 https://ro.farnell.com/yageo/rc0603fr-13100kl/res-100k-1-0-1w-0603-thick- | film/dp/2309107 (https://ro.farnell.com/yageo/rc0603fr-13100kl/res-100k-1-0-1w-0603-thick-film/dp/2309107)
11 https://ro.farnell.com/camdenboss/ctb55vg-2/pcb-terminal-block-low-prof- | 5mm/dp/3498455?gclid=CjwKCAjwge2iBhBBEiwAfXDBR2k6Kt1WkxCi-RRrTUYJm8jfTQctxK83L9vdKgN0eoimf-vJGxne7hoCvbEQAvD_BwE&mckv=_dc|pcrid||plid||kword||match||slid||product|34984 55|pgrid||ptaid||&CMP=KNC-GRO-GEN-SHOPPING-PMax&gross_price=true (https://ro.farnell.com/camdenboss/ctb55vg-2/pcb-terminal-block-low-prof-5mm/dp/3498455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)
12 https://ro.farnell.com/multicomp/bc846b/transistor-npn-0-1a-65v- | sot23/dp/1798074?st=transistor%20npn (https://ro.farnell.com/multicomp/bc846b/transistor-npn-0-1a-65v-sot23/dp/1798074?st=transistor%20npn)
13 https://ro.farnell.com/multicomp/mcgpr25v107m6-3x11/cap-100-f-25v- | 20/dp/9451188?st=electrolitic%20capacitor%20100%20uf (https://ro.farnell.com/multicomp/mcgpr25v107m6-3x11/cap-100-f-25v-20/dp/9451188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)

14 https://ro.farnell.com/tdk/ps1440p02bt/piezoelectronic-buzzer-3v-4khz/dp/3212600

15 https://ro.farnell.com/cree/c535a-wjn-cu0w0231/led-5mm-4-18cd-cool- | white/dp/2839897 (https://ro.farnell.com/cree/c535a-wjn-cu0w0231/led-5mm-4-18cd-cool-white/dp/2839897)
16 https://ro.farnell.com/texas-instruments/lm741cn-nopb/ic-op-amp-compensated-dip8- | 741/dp/3117118?st=lm741 (https://ro.farnell.com/texas-instruments/lm741cn-nopb/ic-op-amp-compensated-dip8-741/dp/3117118?st=lm741)
17 https://ro.farnell.com/texas-instruments/ne555d/precision-timers- | linear/dp/3121191?st=ne555 (https://ro.farnell.com/texas-instruments/ne555d/precision-timers-linear/dp/3121191?st=ne555)

*Nr. Curent de la fiecare link corespunde numărului curent din tabelul BOM de la pagina 9

*Acest document este disponibil și în folder-ul „Foi de catalog”
