bianca10naftanaila/Earthquake-detector/(list of files, drawings)

Other design files:
PCB Project/PROIECT_TIE_DETECTOR_DE_CUTREMUR.DSN
PCB Project/Proiect_TIE_Detector_de_cutremur.opj
